karol-design/MPPT-charger/Hardware/Prototypes and tests/Other tests and examples/Tests 07-03 (4).jpg

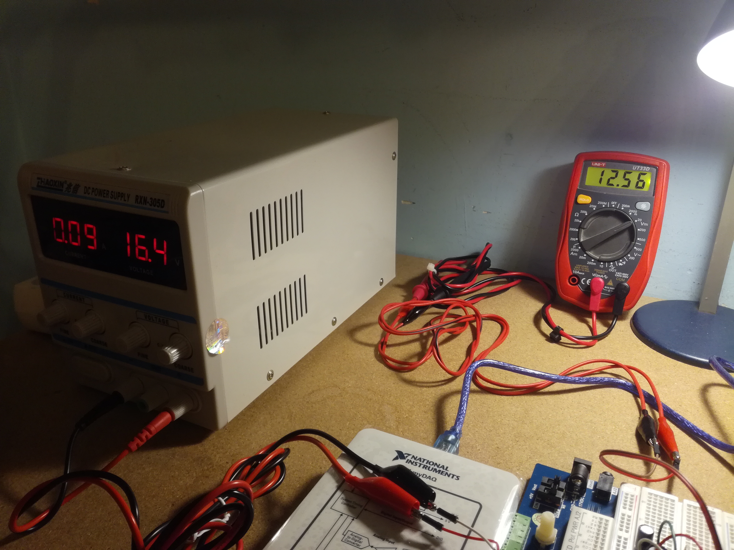
Hardware/Prototypes and tests/Other tests and examples/Tests 07-03 (4).jpg
