karol-design/MPPT-charger/Hardware/(Circuit design) Feedback reference voltage circuit design.pdf

Vaue-(Vg -Vy)» | V4 V
Voca | 12V | Vy | 0, 29 V nal/

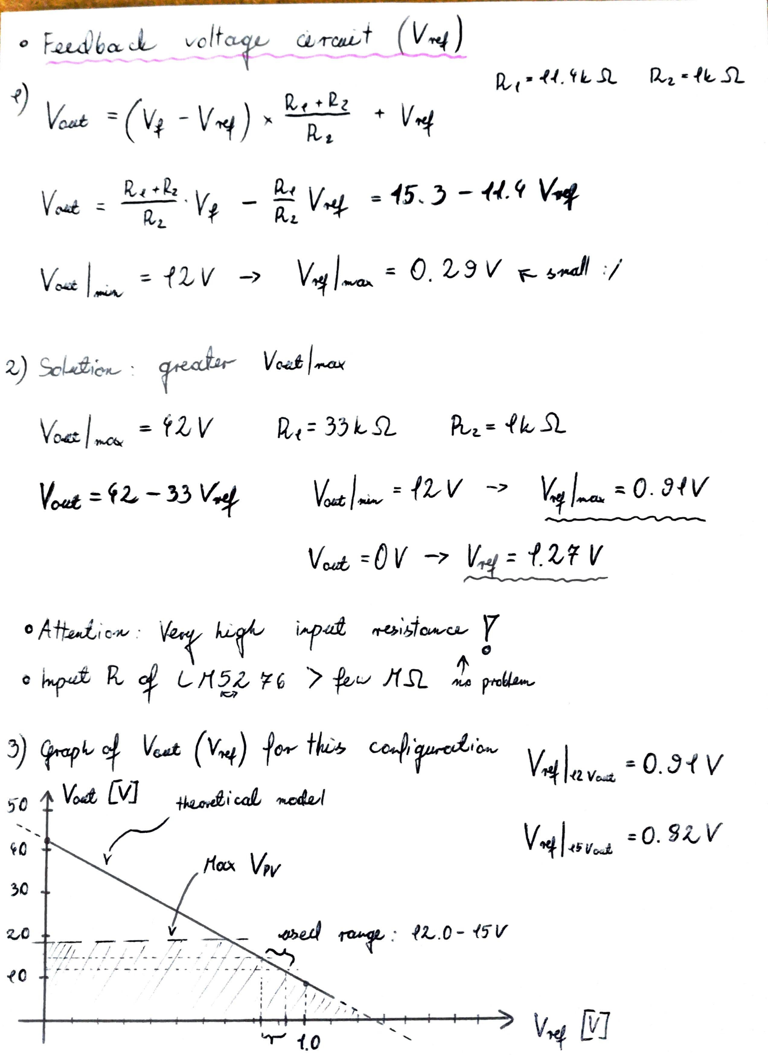
[picture p3: page 1]

Fardba d veltaqu aruit (V)
R44.LIR fe
Rg | AV 15. 3 -4. V
2) Selticn | greactir Voct|ma
2V | Pz | S
Vot =12-33 Vy | Veae12V> | 0. 34V

Veut 0 V Vy= ¹.2FV

Ataniie w: Va kig input isfonc

nA proda
) GrpoVaat (V) fov this co-guncdia V V 0.34V V

so Vct LM haeeti cal nodel

V | 0. 92 V
Max Vv
30

0bed rage: 12.0- 45V

0
V 1 1.0

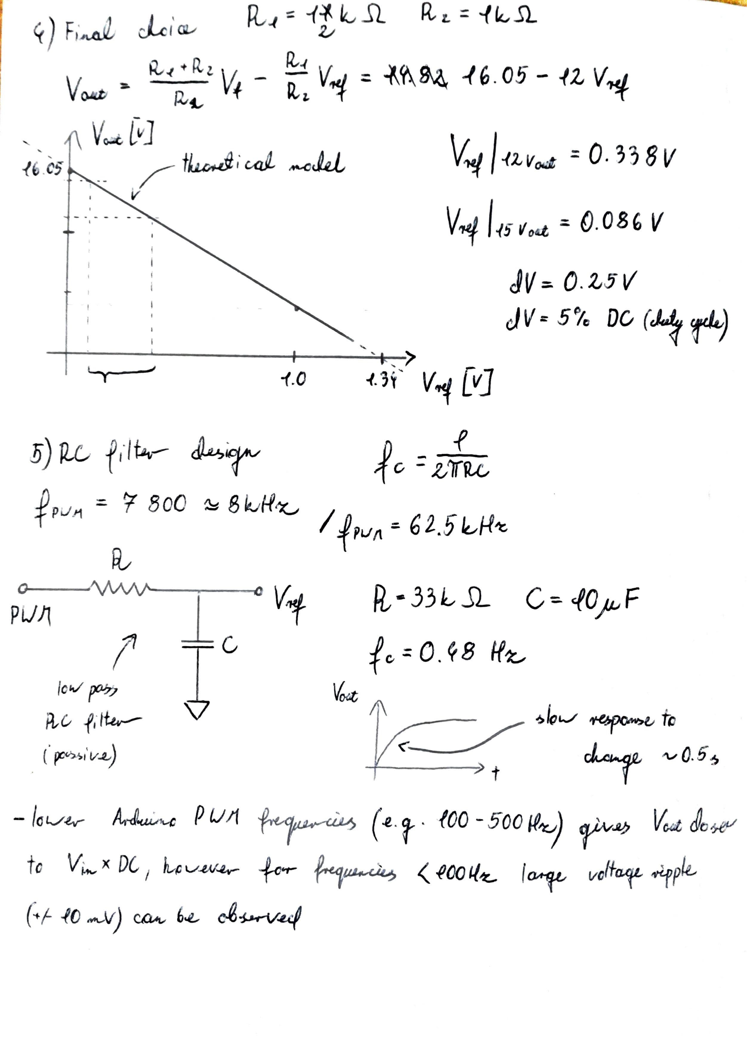
[picture p4: page 2]

G)Fiaal deia
Va | V | Vy = dn84 46.05 42 V Vo | W
hionti cal ncdel | V2Va : 0.338v

Ve45 Va 0.086 V

V= 0.25V

### JV 5% DC (Jy grla)

.0 | .31
Du | S00 8kHr
run | 62.5LH
w | R-33 2 C 40F PUN
=C | 0.48 H
ic por
lo repom to
(psi va | hange v0.55

lowa Ardeuine PUN hequrias (e.q. {00 -500 W) qiva Va dese
to VX DC, heuia tor rqincies e00H larg vetaqt pple

V dese

40 m) ca be cbsrvad

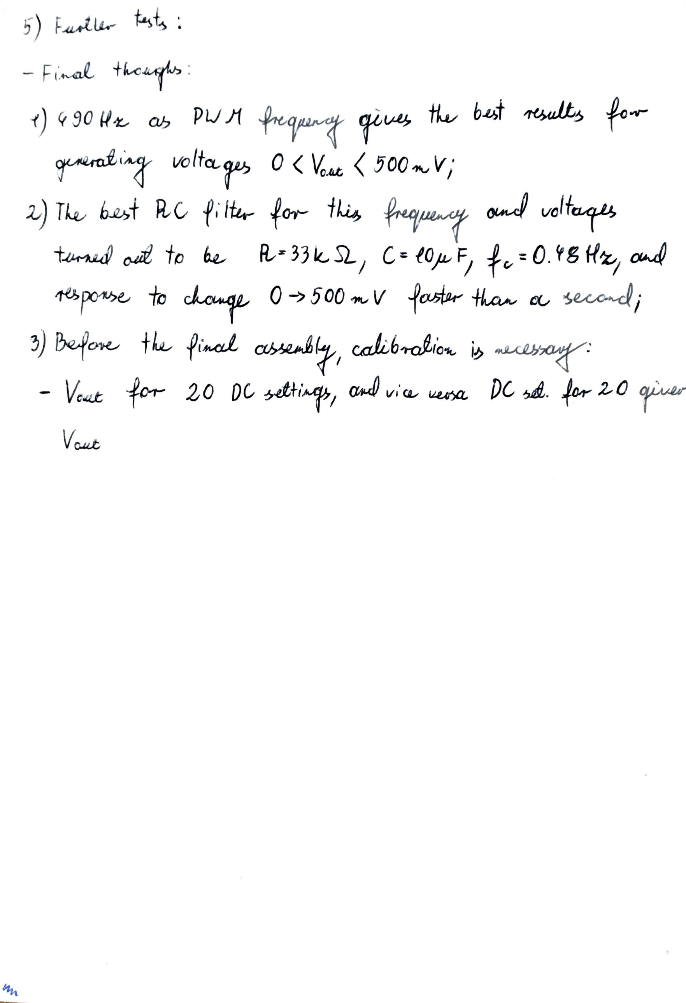
[picture p5: page 3]

5) Fartlir tasts
- Final thcants :
90 H a PUM frqpny ques thu bst rsults fo
graing volta qus O<VueF00V;
2The best RC f te- fo this Pnauy gud veltaqs turrd ou to he R 33L , C-t0pF,f :0.1E He, and
poe to chong 0>500nV ostr than aa secordi
3 Beon the finmel cssenbly calibraion is nmclsoa

Veut or 20 D settings, ad via usa | DC . | for ²⁰ qpue

Vaut

7 Vhad(Vae-Vq) aeR | V Ar(V. V)
0. Vo | Ved V4

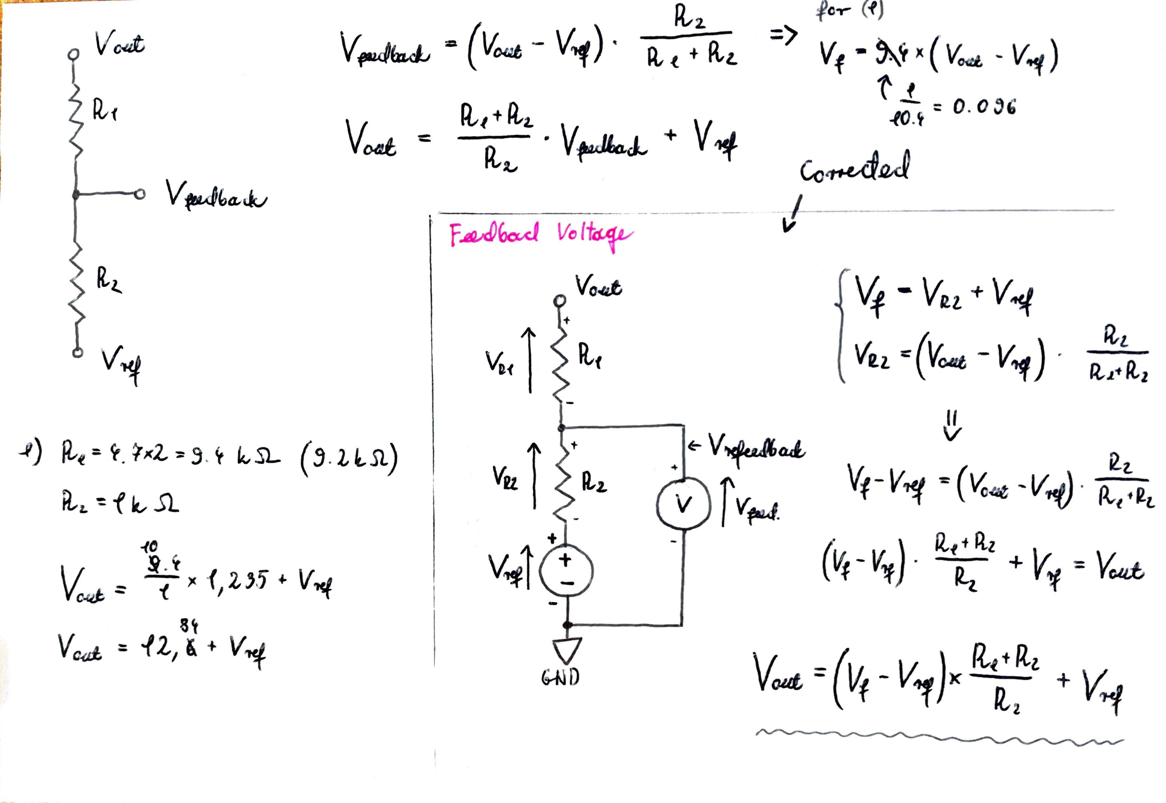
[picture p6: page 4]

for ()

0 0.096

Vodt

Comedod
-o Vuda
Fadeael Ve ltaqu
Vou | - Va V

# Ve-(-V4)k

R f. YA 9.+ k | (9.2La) | Ven | Ve-V (Voe V)R
V | -Yout V | x t,235 V

8

# VV- V

Veust 2, a * V,
GND
