karol-design/MPPT-charger/Hardware/Prototypes and tests/Manual battery charging test (9 March)/Battery charging report.pdf

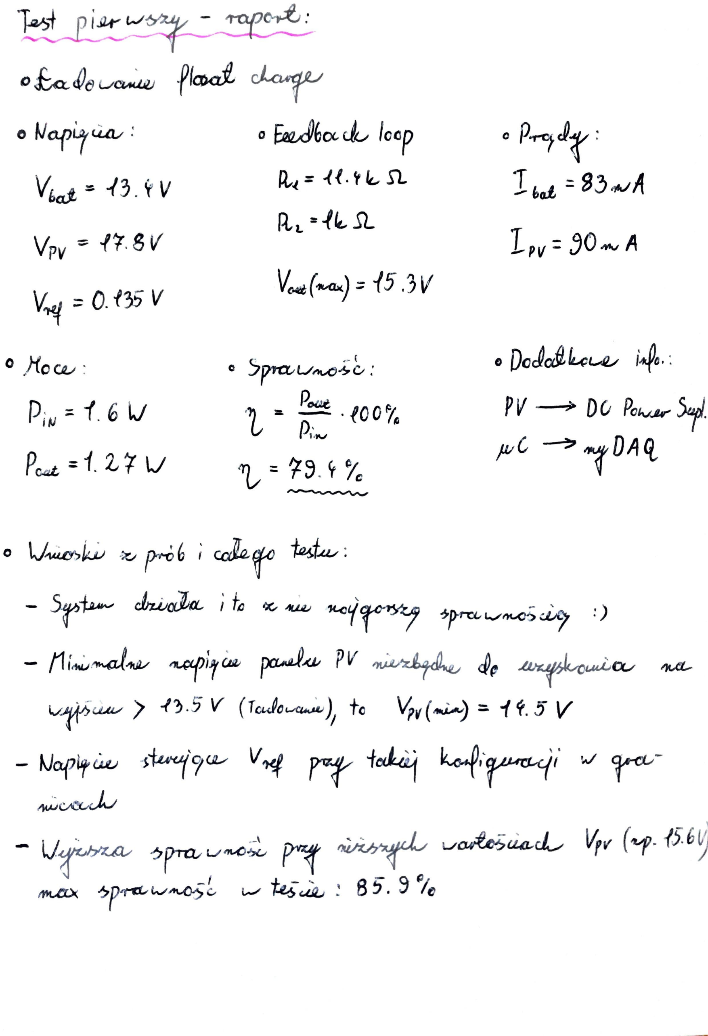
[picture p7: page 1]

Tust pisrws | Tapc
ofadeus | Plaat hagp
o Wapiia: | Exdeor du loap
Viat43.tv | at 93wA
Vpy | 7. SV | Lp 90 A

### Vrana)15 3v V, 0. t35 V

Aocw: | pranose: | Dodet Lecw
P | f.6 w | Peu.00 | PV | DU Posr S.
Peul 1.2 7V | DAQ

huerkw prib i cdego tostu:

Sytn driaka i te uw neygovtg spreuwnosuy i)

- Minalu ropig | paake PV nirhghe de aryskcuia | na
s | 43.5 V (Taudoranu), te | V(ni) = 11.5 V

Napyw stqa V p tedkaj ke-ligi gra

nuwch
Jypra spra une pry niirryc varesuad V (p. 15.6
m prawnosi tes : 85.9%
