karol-design/MPPT-charger/PV System Graph.pdf

&oad Bt/u | Lr LM256 pd6/ Sensor

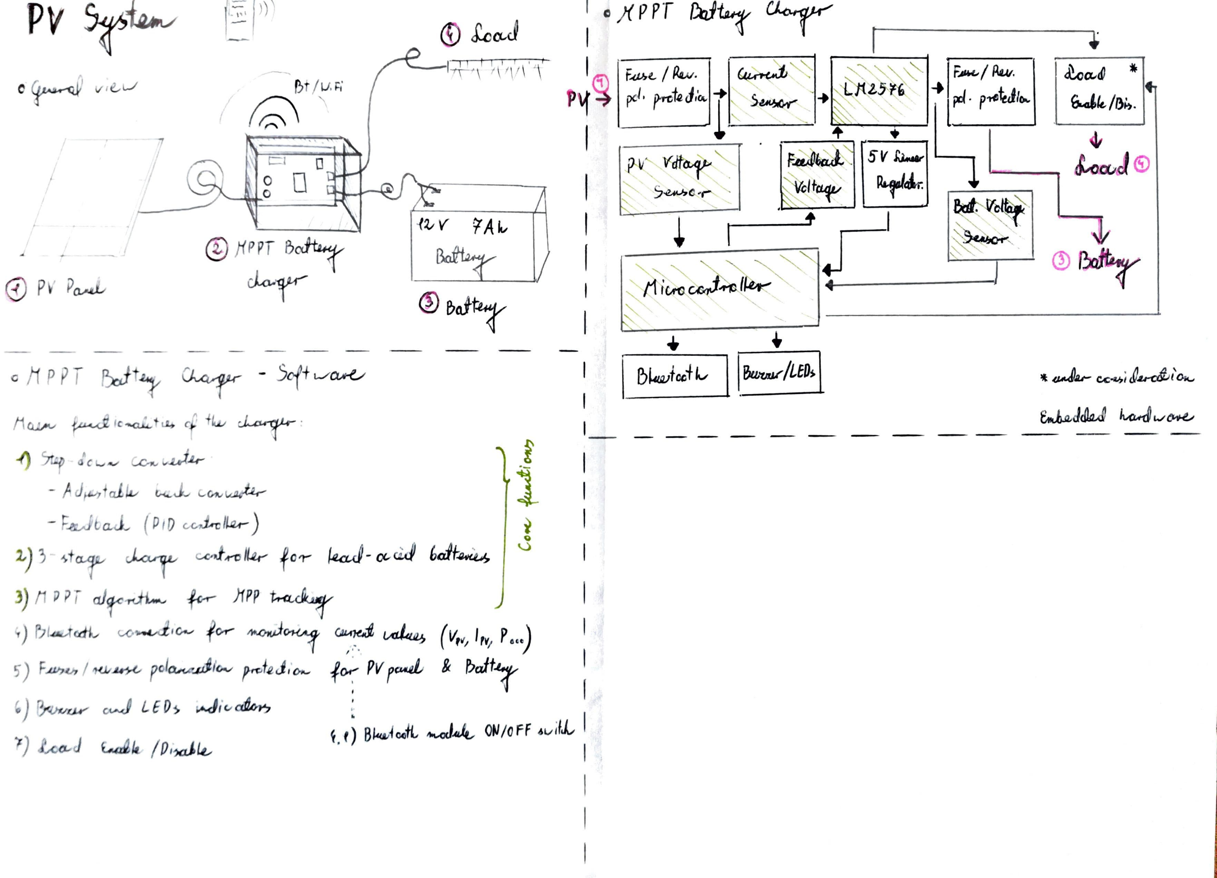
[picture p8: page 1]

PV Syste | XPPT ottary orgr Seod
Fase /Reu. | Currenb
P | pe prcte dial

Fadad5V Aa
Rugaldor
P VataqP | &ocud
Senser | Veltag | Bedt Voltag 2V FA
HPPT Bctu | Bafta
Pv PaL | carger | Micre cerelkr bast
HPPT | Bttay | &apr - Sttuwar | Bleutet Beru /LED | undar casi darcaio
Ma ani icnait | c tu harr | Enba ddas hardwore

Tap dcu con ultr

Adestad te con atir
Fadtas (DID cedelar)
)sta daru otro ler fer kad-ad battavs

) M2P adgentim ter HPP takuy

### )lmtoti omtio for moutonng ne valuus (V, In, Pae

5) FwenI uue polancudio pretedio for PV puel & baty

owur cud LEDs ndivadors
)Lcad aak /Dixadlu | f.) Bluafot moduk ON/O FF suill
