karol-design/MPPT-charger/Battery/Basic charging algorithm.png

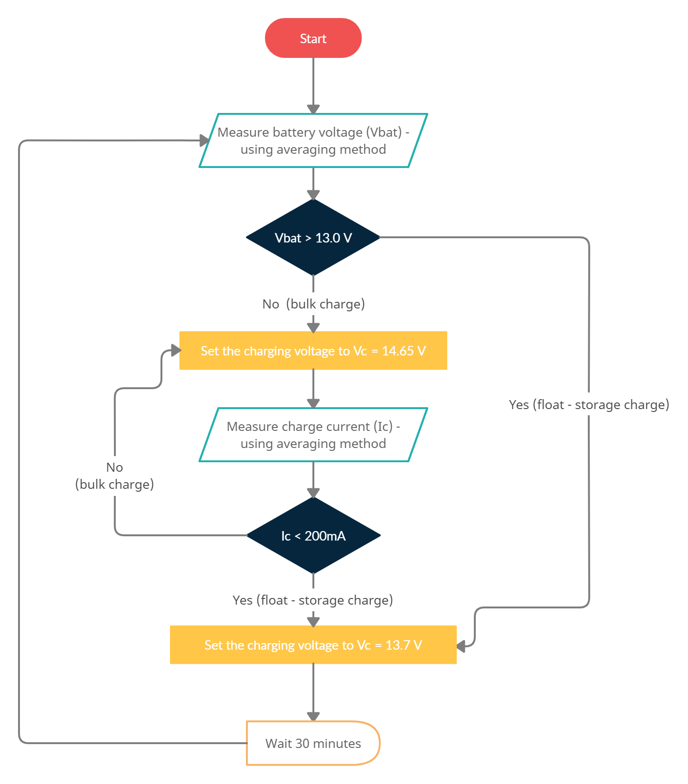
Battery/Basic charging algorithm.png
