karol-design/MPPT-charger/Battery/Charging cycle of a Lead Acid Battery.png

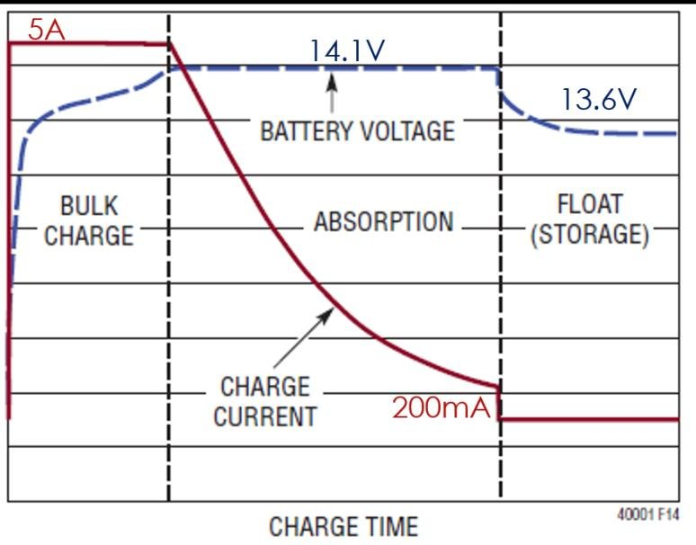
Battery/Charging cycle of a Lead Acid Battery.png
