karol-design/MPPT-charger/Battery/Greeen Cell AGM04 battery (specs).png

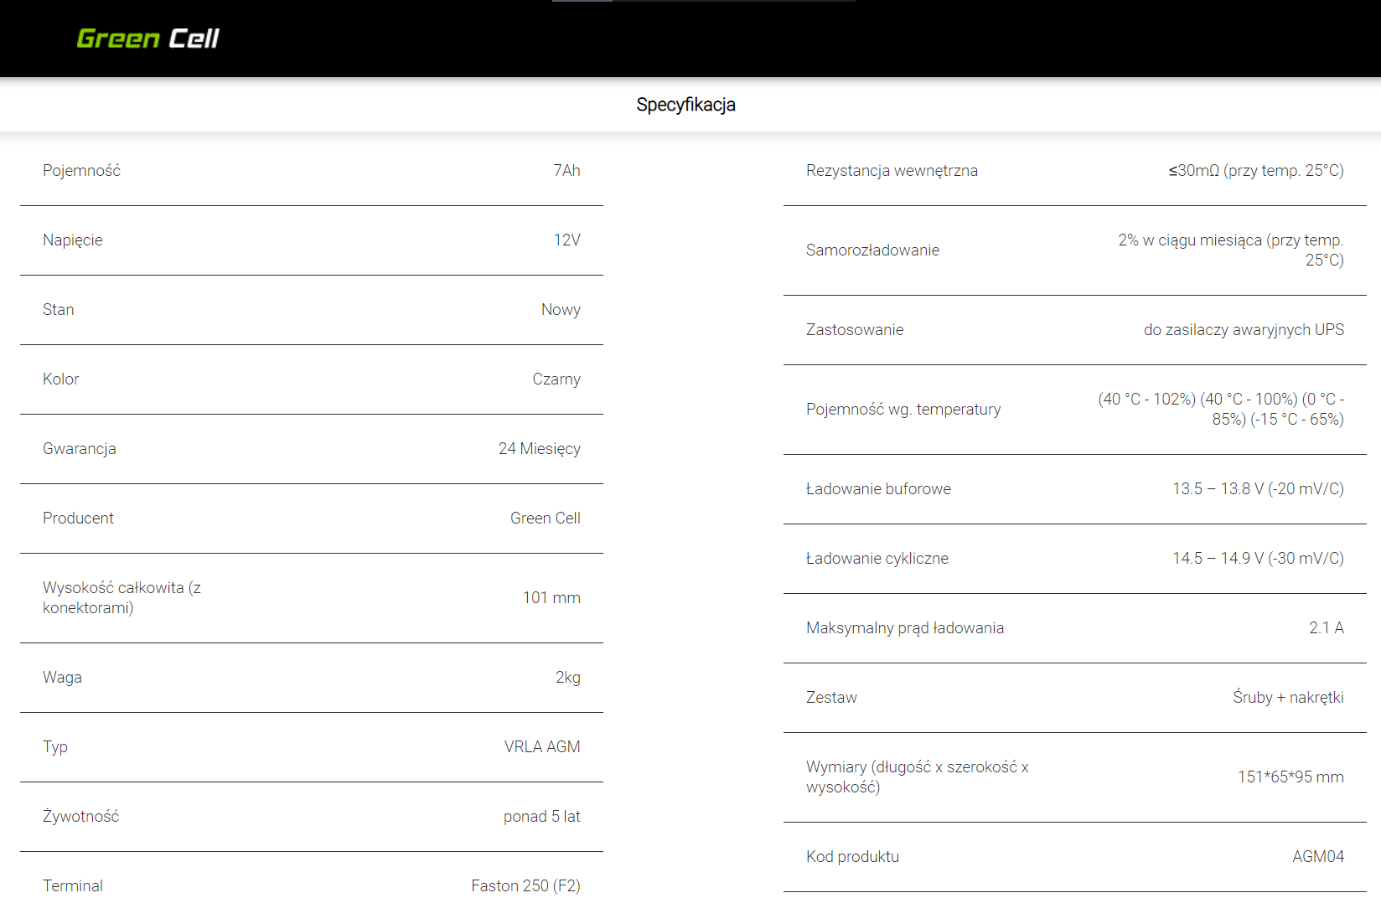
Battery/Greeen Cell AGM04 battery (specs).png
