karol-design/MPPT-charger/Hardware/Atmega328 pinout.png

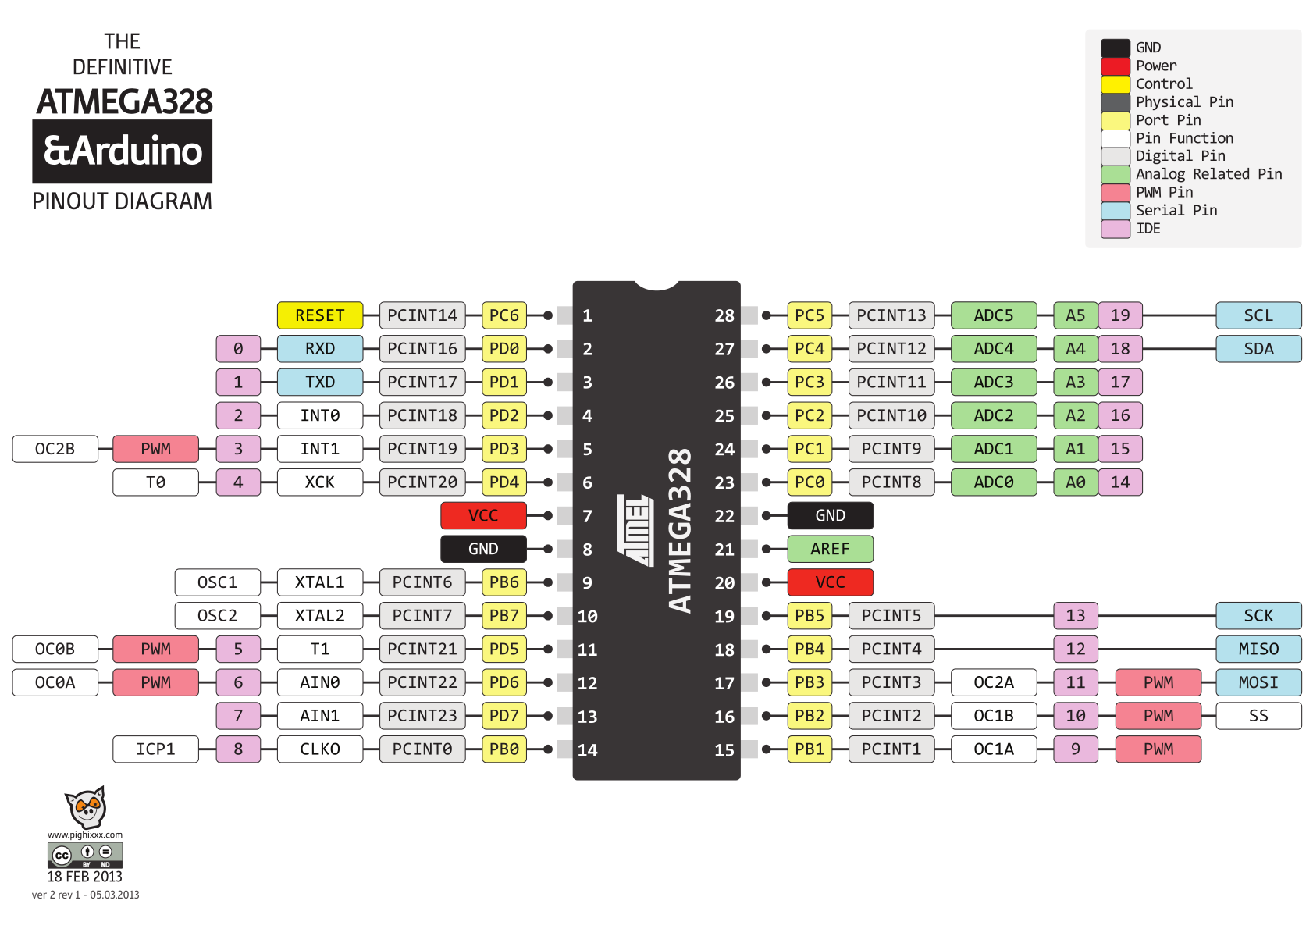
Hardware/Atmega328 pinout.png
