karol-design/MPPT-charger/Hardware/Design files/MPPT Charge Controller - PCB design (top and bottom).png

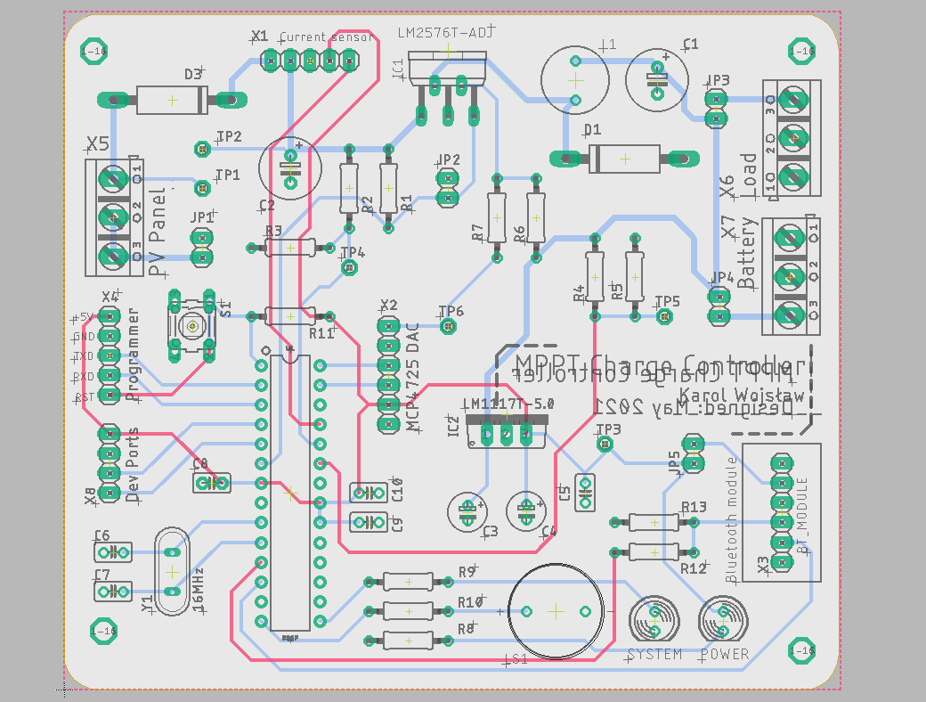
Hardware/Design files/MPPT Charge Controller - PCB design (top and bottom).png
