karol-design/MPPT-charger/Hardware/Design files/MPPT Charge Controller - PCB render (bottom).png

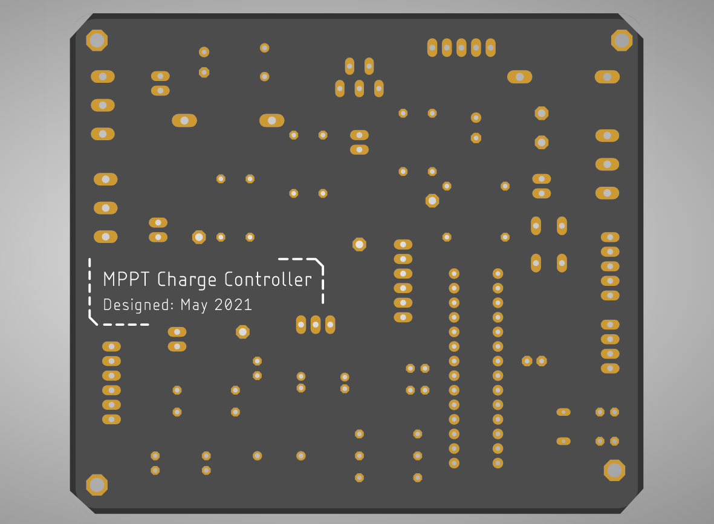
Hardware/Design files/MPPT Charge Controller - PCB render (bottom).png
