karol-design/MPPT-charger/Hardware/Design files/MPPT charge controller - schematic.png

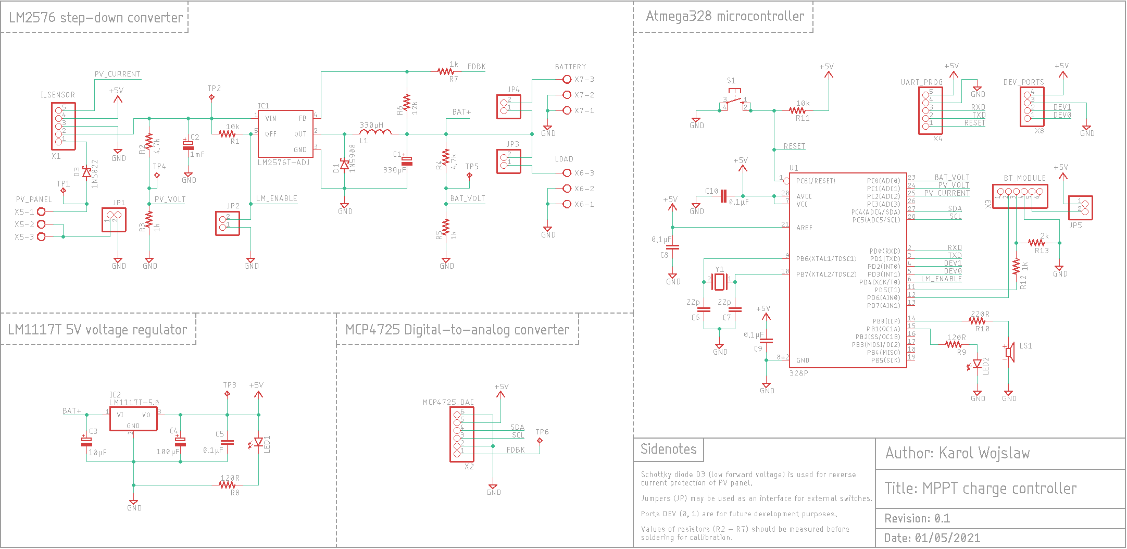
Hardware/Design files/MPPT charge controller - schematic.png
