karol-design/MPPT-charger/PV Panel/Conductance match for maximum power point tracking.png

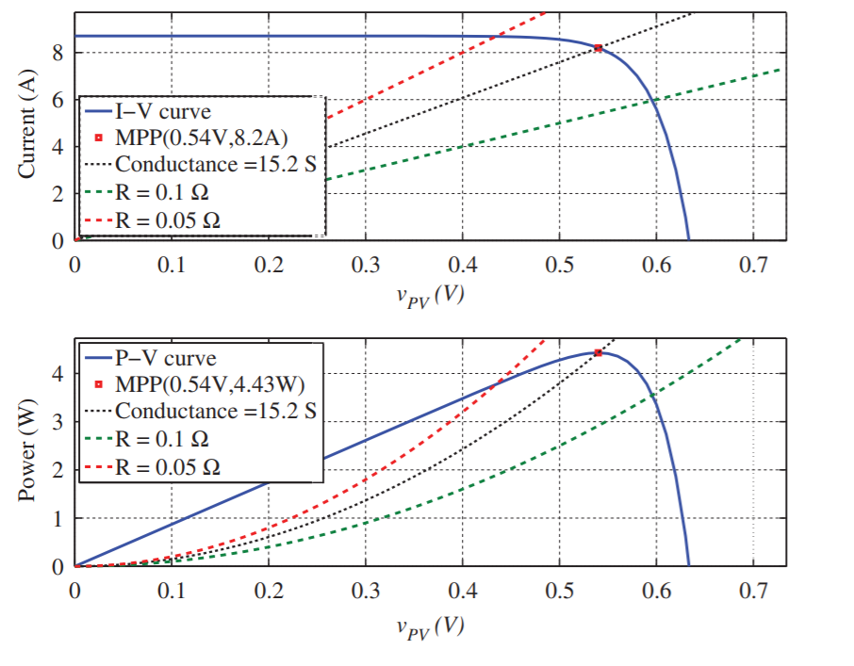
PV Panel/Conductance match for maximum power point tracking.png
