karol-design/MPPT-charger/PV Panel/Exemplary IV curve of Solar Panel #2.jpg

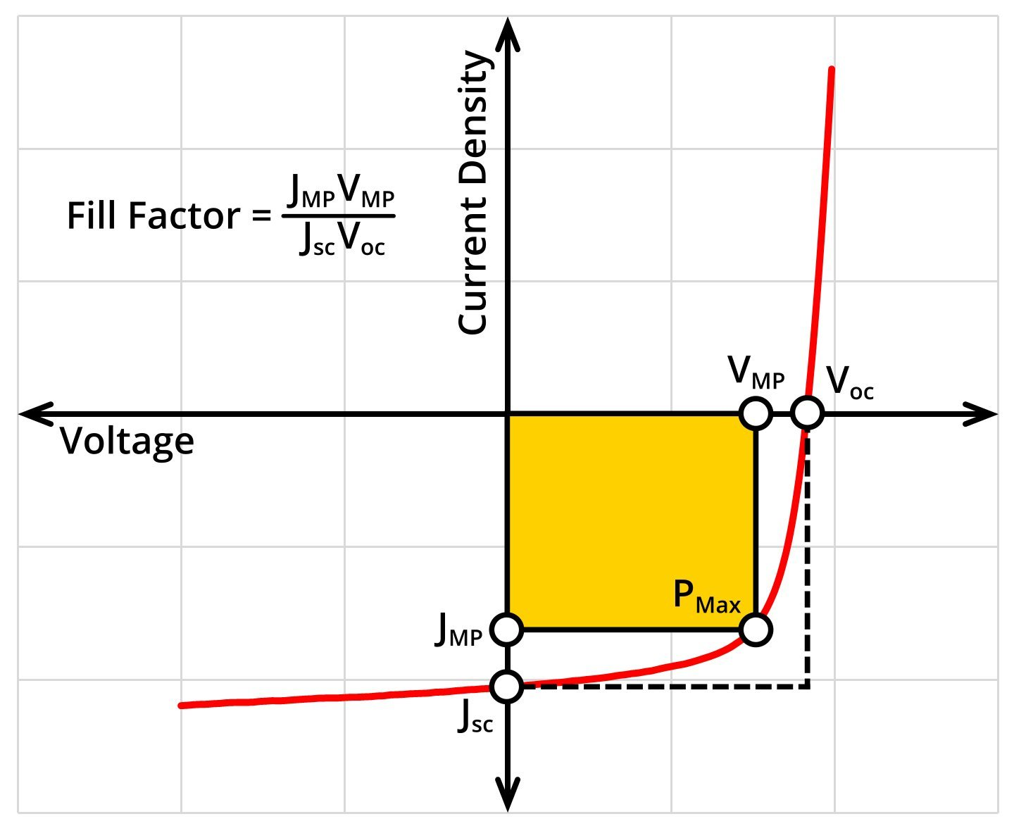
PV Panel/Exemplary IV curve of Solar Panel #2.jpg
