karol-design/MPPT-charger/PV Panel/Exemplary IV curve of Solar Panel.jpg

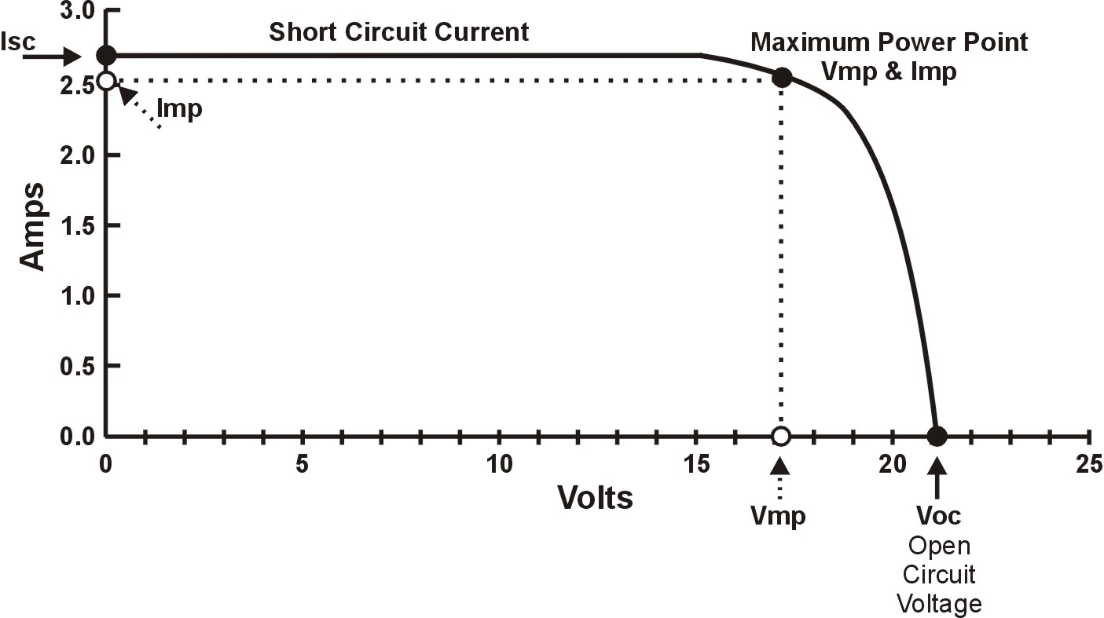
PV Panel/Exemplary IV curve of Solar Panel.jpg
