karol-design/MPPT-charger/Hardware/Design files/MPPT charge controller - partlist.rtf

Partlist

Exported from MPPT Charge Controller.sch at 07/05/2021 00:25

EAGLE Version 9.6.2 Copyright (c) 1988-2020 Autodesk, Inc.

Assembly variant:

Part Value Device Package Library Sheet

C1 330µF CPOL-EUE3.5-8 E3,5-8 rcl 1
C2 1mF CPOL-EUE3.5-8 E3,5-8 rcl 1
C3 10µF CPOL-EUE2-5 E2-5 rcl 1
C4 100µF CPOL-EUE2-5 E2-5 rcl 1
C5 0.1µF C-EU025-025X050 C025-025X050 rcl 1
C6 22p C-EU025-025X050 C025-025X050 rcl 1
C7 22p C-EU025-025X050 C025-025X050 rcl 1
C8 0.1µF C2.5/2 C2.5-2 capacitor-wima 1
C9 0.1µF C-EU025-025X050 C025-025X050 rcl 1
C10 0.1µF C-EU025-025X050 C025-025X050 rcl 1
D1 1N5908 SCHOTTKY-DIODECB417-15 CB417-15 diode 1
D3 1N5822 SCHOTTKY-DIODECB417-15 CB417-15 diode 1
IC1 LM2576T-ADJ LM2576T TO220-5 LM2576_eagle_lib 1
IC2 LM1117T-5.0 7805TV TO220V linear 1
JP1 PINHD-1X2 1X02 pinhead 1
JP2 PINHD-1X2 1X02 pinhead 1
JP3 PINHD-1X2 1X02 pinhead 1
JP4 PINHD-1X2 1X02 pinhead 1
JP5 PINHD-1X2 1X02 pinhead 1
L1 330µH L-US6000-XXX-RC 6000-XXXX-RC rcl 1
LED1 LED5MM LED5MM led 1
LED2 LED5MM LED5MM led 1
LS1 CEM-1205C CEM-1205C CUI_CEM-1205C CEM-1205C 1
R1 10k R-US_0207/10 0207/10 rcl 1
R2 4.7k R-US_0207/10 0207/10 rcl 1
R3 1k R-US_0207/10 0207/10 rcl 1
R4 4.7k R-US_0207/10 0207/10 rcl 1
R5 1k R-US_0207/10 0207/10 rcl 1
R6 12k R-US_0207/10 0207/10 rcl 1
R7 1k R-US_0207/10 0207/10 rcl 1
R8 120R R-US_0207/10 0207/10 rcl 1
R9 120R R-US_0207/10 0207/10 rcl 1
R10 220R R-US_0207/10 0207/10 rcl 1
R11 10k R-US_0207/10 0207/10 rcl 1
R12 1k R-US_0207/10 0207/10 rcl 1
R13 2k R-US_0207/10 0207/10 rcl 1
S1 10-XX B3F-10XX switch-omron 1
TP1 TPPAD1-13 TPPAD1-13 P1-13 testpad 1
TP2 TPPAD1-13 TPPAD1-13 P1-13 testpad 1
TP3 TPPAD1-13 TPPAD1-13 P1-13 testpad 1
TP4 TPPAD1-13 TPPAD1-13 P1-13 testpad 1
TP5 TPPAD1-13 TPPAD1-13 P1-13 testpad 1
TP6 TPPAD1-13 TPPAD1-13 P1-13 testpad 1
U1 328P ATMEGA328P_PDIP DIP28 SparkFun-IC-Microcontroller 1
X1 I_SENSOR PINHD-1X5 1X05 pinhead 1
X2 MCP4725_DAC PINHD-1X6 1X06 pinhead 1
X3 BT_MODULE PINHD-1X6 1X06 pinhead 1
X4 UART_PROG PINHD-1X5 1X05 pinhead 1
X5 PV_PANEL AK500/3 AK500/3 con-ptr500 1
X6 LOAD AK500/3 AK500/3 con-ptr500 1
X7 BATTERY AK500/3 AK500/3 con-ptr500 1
X8 DEV_PORTS PINHD-1X4 1X04 pinhead 1
Y1 16MHz XTAL/S QS special 1
