karol-design/MPPT-charger/Hardware/(Circuit design) LM2576 components values calculations.pdf

# C,C)'lv vJ.u- J~;r

~ ~ -- --~ _J

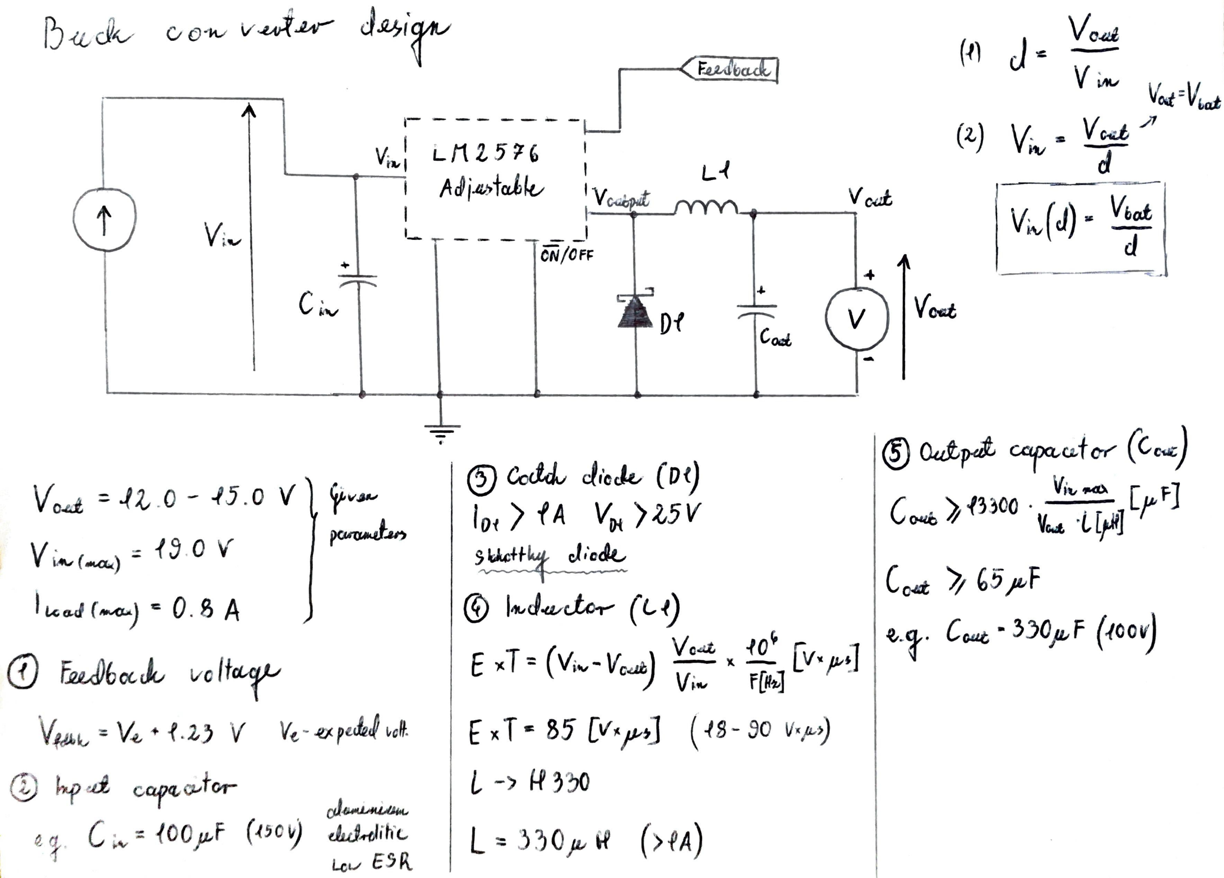
[picture p19: page 1]

v,.,, L/12.51b 1

( ~bd]

### L..( ---~, A cP j4' tcJtv : V

I | ~ | .-.--__ Vwt | Viv(J)- ~ '- | d

## Ci.v

V o.d : ~ i . 0 - -f 5 . 0 V ~v.,._,
V i.-- < -> = -( 5 O V po,v,J..,,

} uo.<1 <~) C: 0. s A

# (J) fuJ60(,Ju VO ff~

V ~iv = v-'l, ,. f . 2, v v(, -JlX p,,JtJ ~(J~.

@ J..,f ai c~ c,.Jor | cJ~

if [.., = -(OO p,f (m1 ,J,,J..J;h·t
| Lc,v E5 R.
- _I
ON/OFF

## ~ ~Jdv J,·ok (D<)

### I Ot I f A V rx ) t5 V

~ft~ J,·atk,

## ® 1~J-u.,c.k, (t1

Coat

E T - (v | Vo4 | -to~ r; ')( - | iv .. Vc.uii\ - | X - | Lv .. p;~l / Vi~ | f[II~ | -

## E x T c B 5 [ v 1' ~~J ( ~ g - so v ~ ~})

L -) ~ '"°

# L :: 3 ) 0 ~ ~ (> f A)

## @~,,J, ccr,ufw (c=)

## G c>"C ) -moo . V;., '."" [r f] Vw. ·t [ptJ

(04 4 ~5~F

## ii-f. Coat.· 3JOp,F (100v)
