karol-design/MPPT-charger/Hardware/Prototypes and tests/Voltage feedback test (11 March)/Tests with Operational Amplifier as a buffer (600mV no matter what input).png

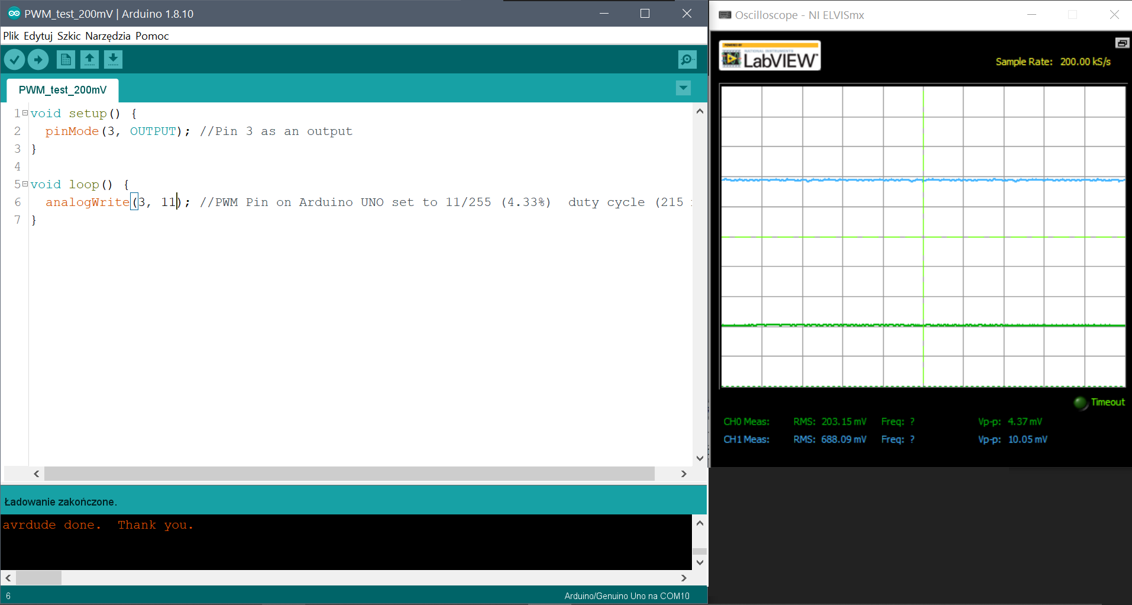
Hardware/Prototypes and tests/Voltage feedback test (11 March)/Tests with Operational Amplifier as a buffer (600mV no matter what input).png
