karol-design/MPPT-charger/Hardware/Prototypes and tests/Battery charger test (21 Apr)/Battery charger test (21 Apr) - data.xlsx

Data logged during charging test (raw data) |  |  |  |  |  |  |  | Data logged during charging test (graph conditioned data)
Minute | Mode | Charging Voltage | Battery Voltage | PV Panel Voltage | PV Panel Current | Power delivered | SOC | Minute | Mode | Charging Voltage | Battery Voltage | PV Panel Voltage | PV Panel Current | Power delivered | SOC
1 | 1 | 12988 | 12988 | 18752 | 8 | 150 | 89 | 1 | 11000 | 12988 | 12988 | 18752 | 80 | 150 | 89
2 | 1 | 14044 | 12912 | 16676 | 506 | 8438 | 84 | 2 | 11000 | 14044 | 12912 | 16676 | 5060 | 8438 | 84
3 | 1 | 14075 | 12912 | 16676 | 506 | 8438 | 84 | 3 | 11000 | 14075 | 12912 | 16676 | 5060 | 8438 | 84
4 | 1 | 14075 | 12937 | 16644 | 502 | 8355 | 85 | 4 | 11000 | 14075 | 12937 | 16644 | 5020 | 8355 | 85
5 | 1 | 14013 | 12937 | 16613 | 482 | 8007 | 85 | 5 | 11000 | 14013 | 12937 | 16613 | 4820 | 8007 | 85
6 | 1 | 14044 | 12937 | 16582 | 480 | 7959 | 85 | 6 | 11000 | 14044 | 12937 | 16582 | 4800 | 7959 | 85
7 | 1 | 14013 | 12937 | 16582 | 476 | 7893 | 85 | 7 | 11000 | 14013 | 12937 | 16582 | 4760 | 7893 | 85
8 | 1 | 14013 | 12937 | 16551 | 473 | 7828 | 85 | 8 | 11000 | 14013 | 12937 | 16551 | 4730 | 7828 | 85
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
