karol-design/MPPT-charger/Hardware/Prototypes and tests/Battery charger test (21 Apr)/Battery charger test (21 Apr) - graph #1.png

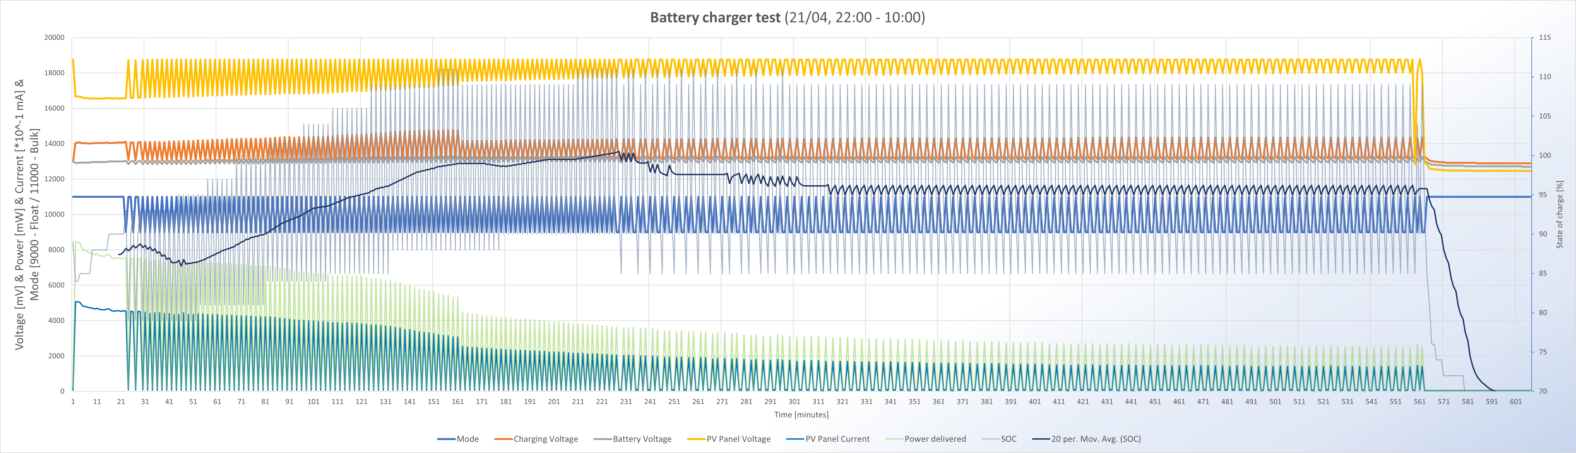
Hardware/Prototypes and tests/Battery charger test (21 Apr)/Battery charger test (21 Apr) - graph #1.png
