karol-design/MPPT-charger/Hardware/Prototypes and tests/Manual battery charging test (5 Apr)/Tests 05-04 (1).jpg

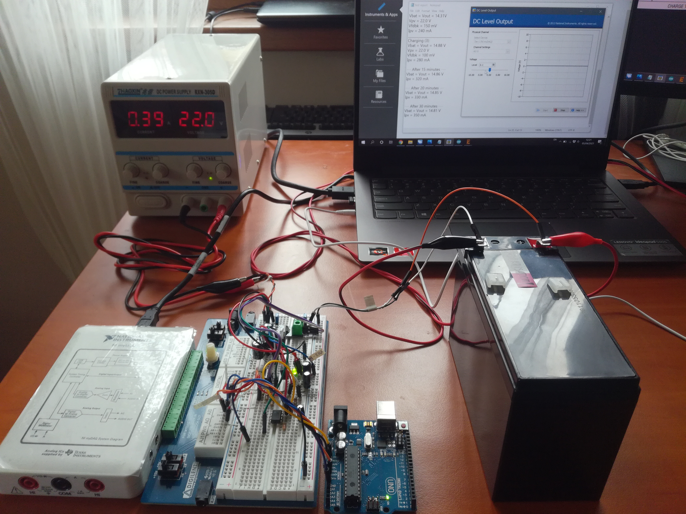
Hardware/Prototypes and tests/Manual battery charging test (5 Apr)/Tests 05-04 (1).jpg
