karol-design/MPPT-charger/Hardware/Prototypes and tests/Manual battery charging test (9 March)/Tests 09-03 (2).jpeg

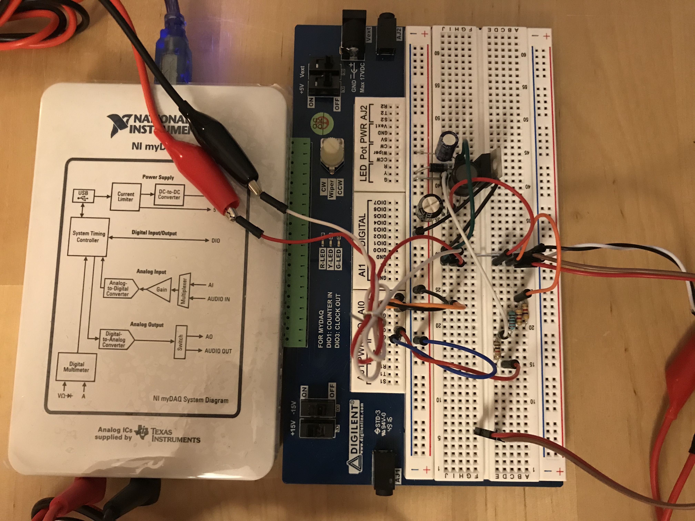
Hardware/Prototypes and tests/Manual battery charging test (9 March)/Tests 09-03 (2).jpeg
