karol-design/MPPT-charger/Hardware/Prototypes and tests/Manual battery charging test (9 March)/Tests 09-03 (3).jpeg

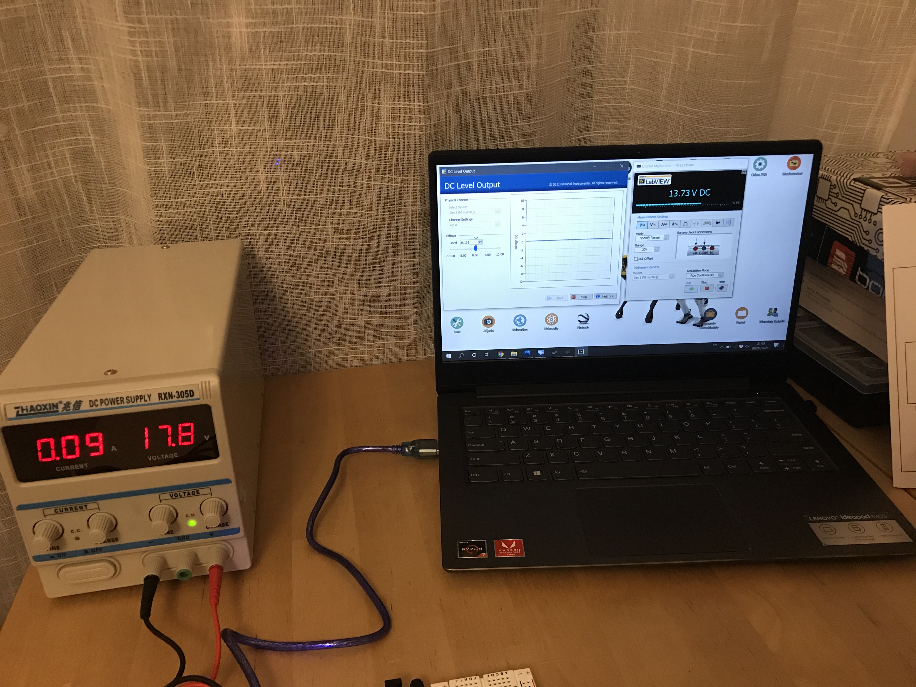
Hardware/Prototypes and tests/Manual battery charging test (9 March)/Tests 09-03 (3).jpeg
