karol-design/MPPT-charger/Hardware/Prototypes and tests/Other tests and examples/Tests 07-03 (1).jpg

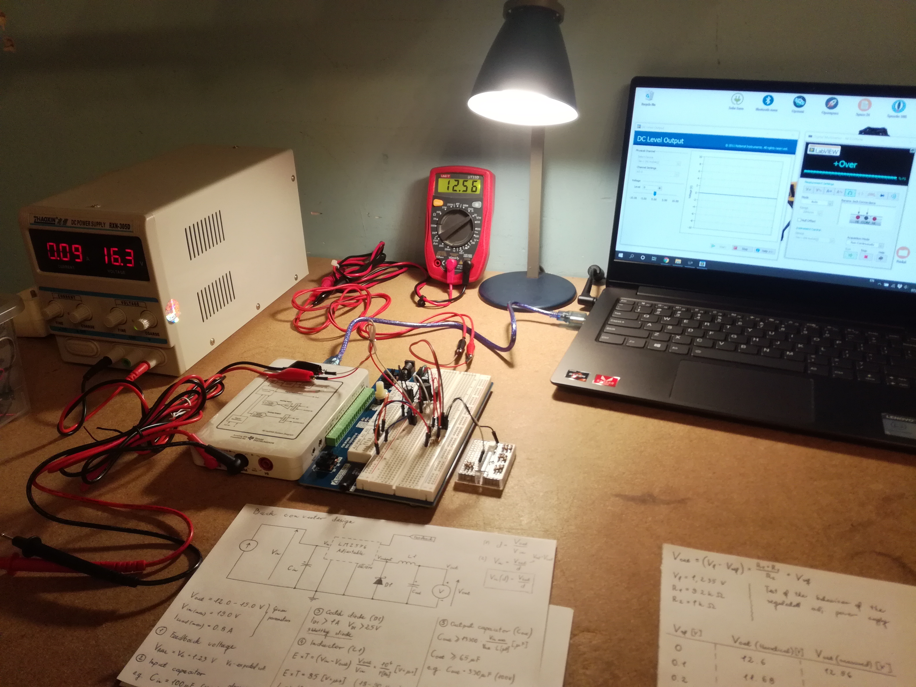
Hardware/Prototypes and tests/Other tests and examples/Tests 07-03 (1).jpg
