karol-design/MPPT-charger/Hardware/Prototypes and tests/Other tests and examples/Tests 24 & 30-03 (3).jpg

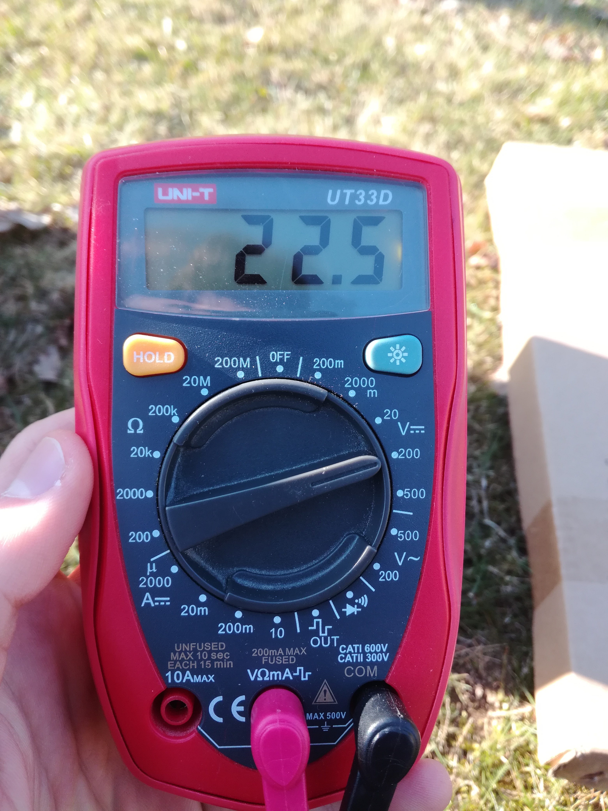
Hardware/Prototypes and tests/Other tests and examples/Tests 24 & 30-03 (3).jpg
