karol-design/MPPT-charger/Hardware/Prototypes and tests/Other tests and examples/V_out example from myDAQ AO.png

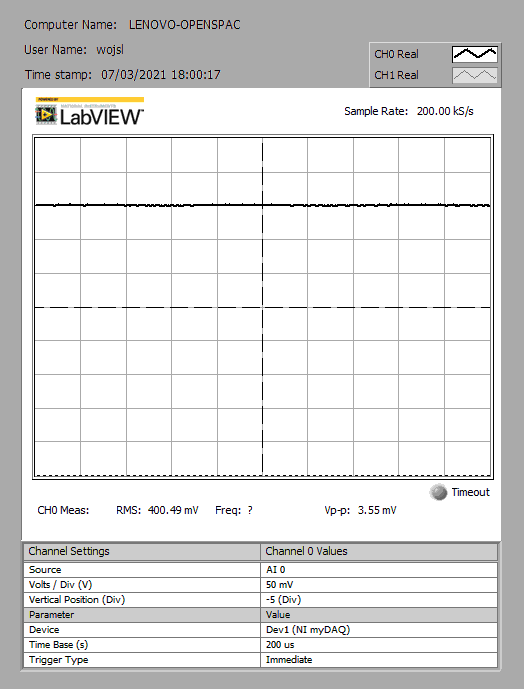
Hardware/Prototypes and tests/Other tests and examples/V_out example from myDAQ AO.png
