karol-design/MPPT-charger/Hardware/Prototypes and tests/Voltage feedback test #2 (28 March)/FDBK_connected_to_DAC(100mV).png

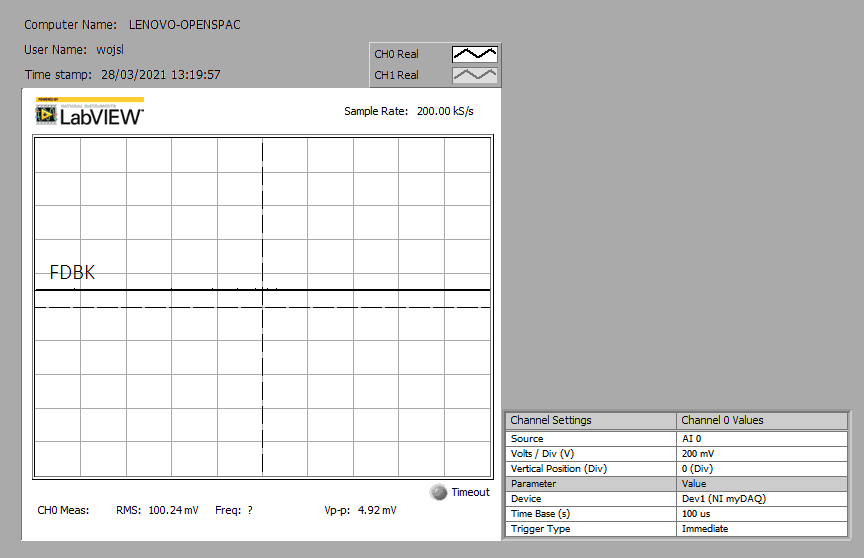
Hardware/Prototypes and tests/Voltage feedback test #2 (28 March)/FDBK_connected_to_DAC(100mV).png
