karol-design/MPPT-charger/Hardware/Prototypes and tests/Voltage feedback test #2 (28 March)/Figure 1 - OpAmp test summary.png

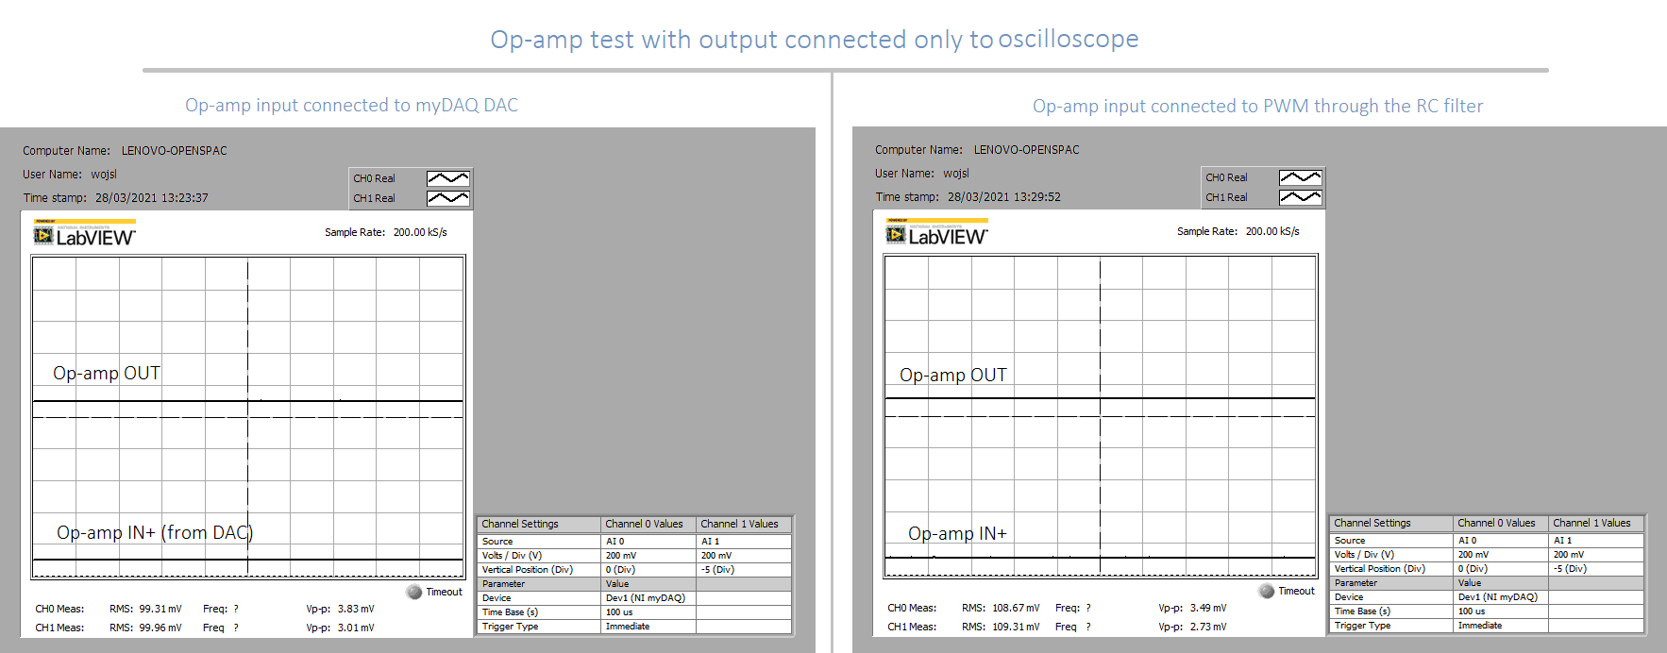
Hardware/Prototypes and tests/Voltage feedback test #2 (28 March)/Figure 1 - OpAmp test summary.png
