karol-design/MPPT-charger/Hardware/Prototypes and tests/Voltage feedback test #2 (28 March)/Figure 2 - FDBK connected to DAC(100mV) through OpAmp.png

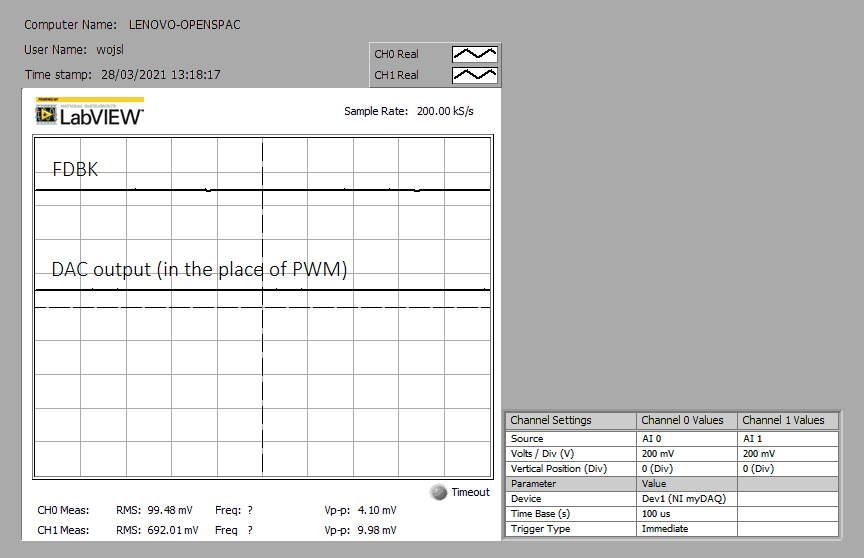
Hardware/Prototypes and tests/Voltage feedback test #2 (28 March)/Figure 2 - FDBK connected to DAC(100mV) through OpAmp.png
