karol-design/MPPT-charger/Hardware/Prototypes and tests/Voltage feedback test #2 (28 March)/Figure 3 - PWM and RC filter Output.png

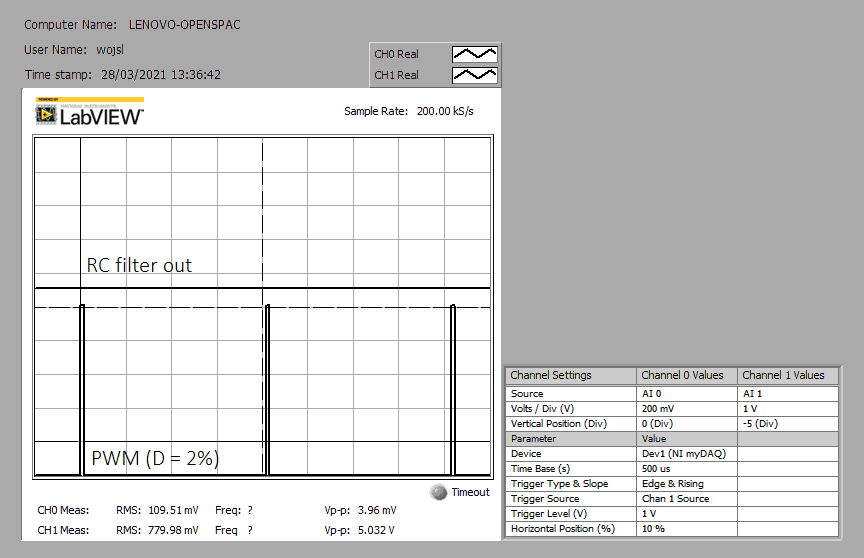
Hardware/Prototypes and tests/Voltage feedback test #2 (28 March)/Figure 3 - PWM and RC filter Output.png
