karol-design/MPPT-charger/Hardware/Prototypes and tests/Voltage feedback test (11 March)/Osciloscope readings (2% Duty cycle - 490 Hz).png

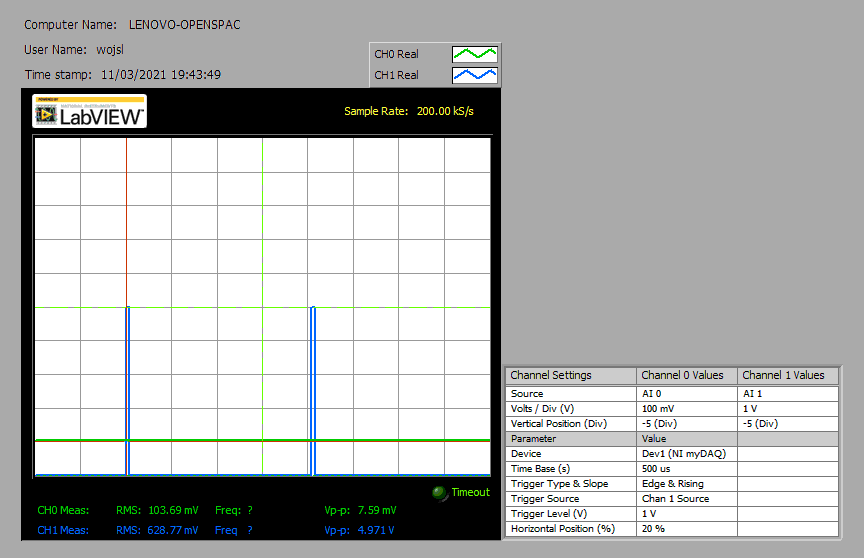
Hardware/Prototypes and tests/Voltage feedback test (11 March)/Osciloscope readings (2% Duty cycle - 490 Hz).png
