karol-design/MPPT-charger/Hardware/Datasheets/DS1002-01 Test Point (dataheet).pdf

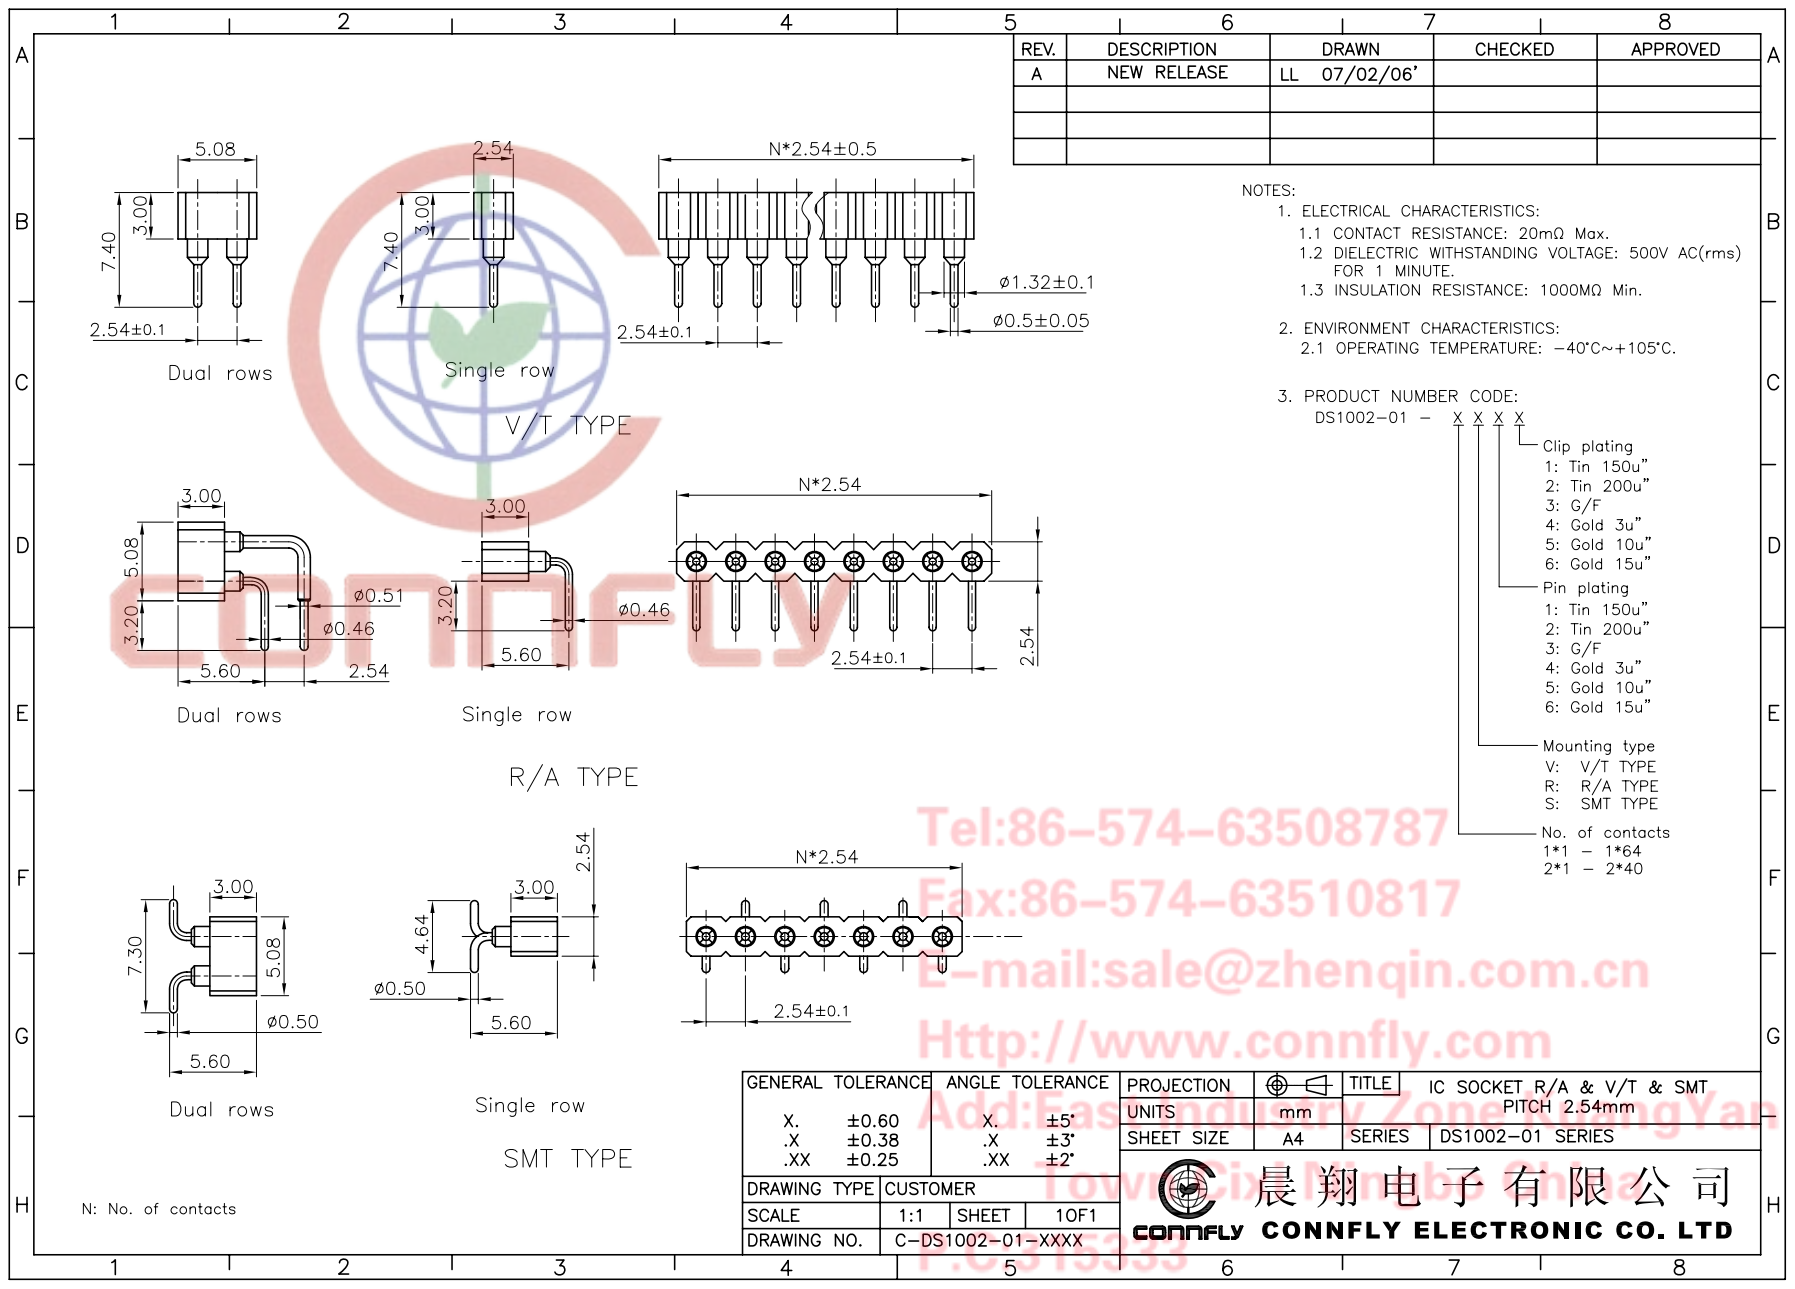
[picture p35: page 1]
