karol-design/MPPT-charger/#0 Out-of-date and other files/PV_power_board_0.2.brd

## EAGLE design #0 Out-of-date and other files/PV_power_board_0.2.brd (2021-04-03, last stored version)

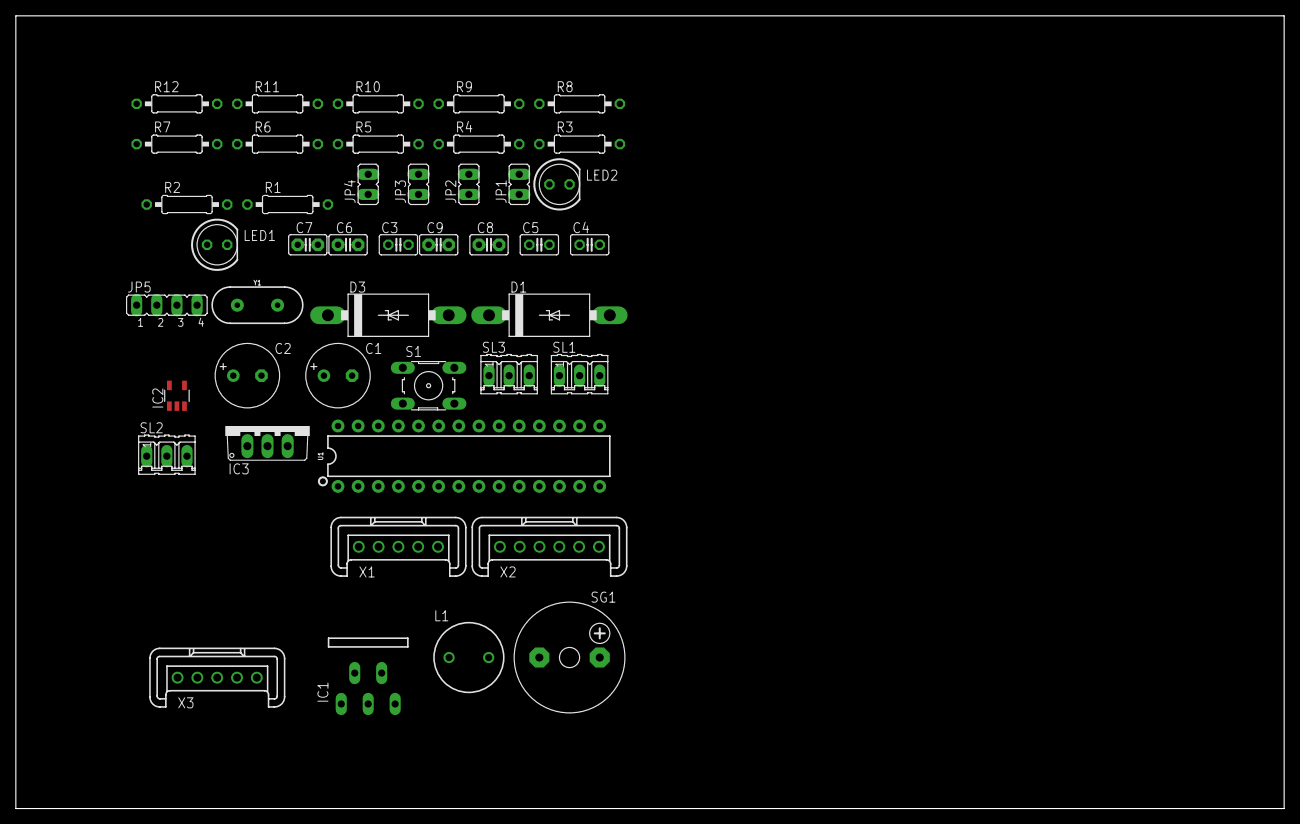
[picture p36: board PV_power_board_0.2.brd from above]

Board: 2 copper layers, 160.0 x 100.0 mm, 44 parts (0 on the bottom side), 34 nets, no tracks yet.

Parts:
C1: 330µF; E3,5-8
C2: 100µF; E3,5-8
C3: 10µF; C025-025X050
C4: 0.33µF; C025-025X050
C5: 0.1µF; C025-025X050
C6, C7: 22p; C2.5-2
C8, C9: 100n; C2.5-2
D1: 1N5908; C4111-15
D3: STPS2L60; C4111-15
IC1: LM2576T; TO220-5
IC2: LMV358; SOT23-5
IC3: 7805TV; TO220V
JP1, JP2, JP3, JP4: JP1
JP5: JP4
L1: 330µH; 6000-XXXX-RC
LED1, LED2: LED5MM
R1, R12: 10k; 0207/10
R2: 33k; 0207/10
R3: 4.7k; 0207/10
R4, R6, R9: 1k; 0207/10
R5: 4.7; 0207/10
R7, R10: 120R; 0207/10
R8: 12k; 0207/10
R11: 220R; 0207/10
S1: B3F-10XX
SG1: F/CM12P
SL1: BATTERY; 03P
SL2: PV_PANEL; 03P
SL3: LOAD; 03P
U1: 328P; DIP28
X1: I_SENSOR; MKS1855-6-0-505
X2: BT_MODULE; MKS1856-6-0-606
X3: PROGRAM_PORT; MKS1855-6-0-505
Y1: 16MHz; HC49US

Connections:
+5V: C5.1, C9.2, IC2.5, IC3.3, JP4.2, JP5.4, LED1.A, R1.2, R12.1, U1.7, U1.20, X1.4, X3.5
BAT+: C1.+, C4.1, IC3.1, JP1.2, JP3.1, L1.1, R5.2, R8.1
BAT_VOLT: R5.1, R6.2, U1.25
DEV0: JP5.1, U1.27
DEV1: JP5.2, U1.26
FDBK: IC2.3, IC2.4, R9.1
GND: C1.-, C2.-, C3.2, C4.2, C5.2, C6.1, C7.1, C8.1, C9.1, D1.A, IC1.3, IC2.2, IC3.2, JP2.2, JP5.3, LED2.K, R4.1, R6.1, R7.2, S1.3, S1.4, SG1.-, SL1.2, SL1.3, SL3.2, SL3.3, U1.8, U1.22, X1.3, X2.4, X3.4
LM_ENABLE: IC1.5, R1.1
LM_FEEDBACK: IC1.4, R8.2, R9.2
LM_VIN: C2.+, IC1.1, R3.2, X1.2
unnamed: D1.C, IC1.2, L1.2
unnamed: C3.1, IC2.1, R2.1
unnamed: D3.C, X1.1
unnamed: LED1.K, R7.1
unnamed: D3.A, SL2.3
unnamed: JP1.1, SL3.1
unnamed: C6.2, U1.9, Y1.2
unnamed: R11.2, U1.14
unnamed: C7.2, U1.10, Y1.1
unnamed: JP3.2, SL1.1
unnamed: R10.2, U1.15
unnamed: LED2.A, R10.1
unnamed: C8.2, U1.21
unnamed: R11.1, SG1.+
unnamed: U1.6, X2.2
unnamed: U1.11, X2.3
unnamed: JP2.1, SL2.1, SL2.2
unnamed: JP4.1, X2.5
PV_CURRENT: U1.24, X1.5
PV_VOLT: R3.1, R4.2, U1.23
PWM: R2.2, U1.5
RESET: R12.2, S1.1, S1.2, U1.1, X3.1
RXD: U1.2, X3.3
TXD: U1.3, X3.2
