karol-design/MPPT-charger/(commit log)

2021-04-02 Arduino file added to a folder
2021-04-02 Update in the full software version
    - SetCharging function added
    - Bulk/Float charging
    - LM_ENABLE_PIN added
2021-04-03 Buzzer, LED, PWM off by default
    [Charger-Software-full.ino]
2021-04-03 File organisation update
    [MPPT Charge Controller.sch]
2021-04-03 File organisation change
    [MPPT Charge Controller.sch]
2021-04-03 Var types update, MPPT algorithm implementation, initial charging voltage added,
2021-04-04 Arduino C++ Cheat Sheet added
2021-04-04 Calibration values included
2021-04-04 Create Arduino UNO pinout.jpg
2021-04-07 Change in capacitor value
2021-04-07 Updates: calibration, measurements, reports
2021-04-20 Update in the main Source Code
    Code not exactly consistent with the best current version - charger-test
2021-04-20 Battery charger test code added
2021-04-20 Schematics update (MCP4725 connector, I2C)
2021-04-22 Update in tests folder organisation
    [Battery charger test (21 Apr) - data.xlsx]
2021-05-07 Hardware design files updated
    [MPPT Charge Controller.sch]
2021-06-16 Further changes in the test and calibration code
2021-06-16 Minor changes to manual battery charger files
2021-06-16 Voltage set proportional controller algorithm included
2021-06-16 Debuging Serial.print lines added
2021-06-16 Changes to Manual battery charger test
2021-06-16 Minor changes to Serial prints
2021-06-16 Test report data
    [16.06 - PV Panel with charge controller tests data.xlsx]
2022-02-05 Restructure folders
    [16.06 - PV Panel with charge controller tests data.xlsx, MPPT Charge Controller.sch, PV_power_board_0.1.sch, PV_power_board_0.2.brd, PV_power_board_0.2.sch, Texas instrument Buck converter calculator.xls]
